apapam02/Audio-Modulated-555-based-flyback-driver/images/driver_top.jpg

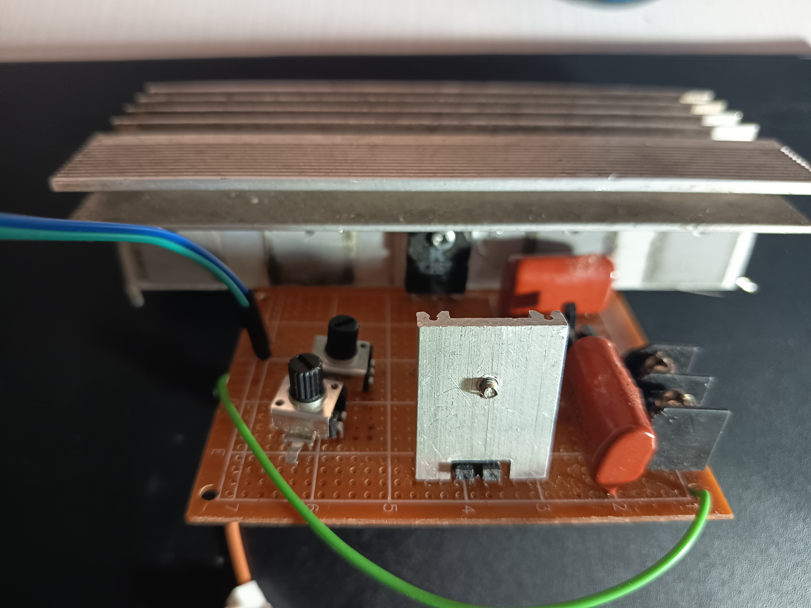
images/driver_top.jpg
