apapam02/Audio-Modulated-555-based-flyback-driver/images/Screenshot 2026-10-02 194719.png

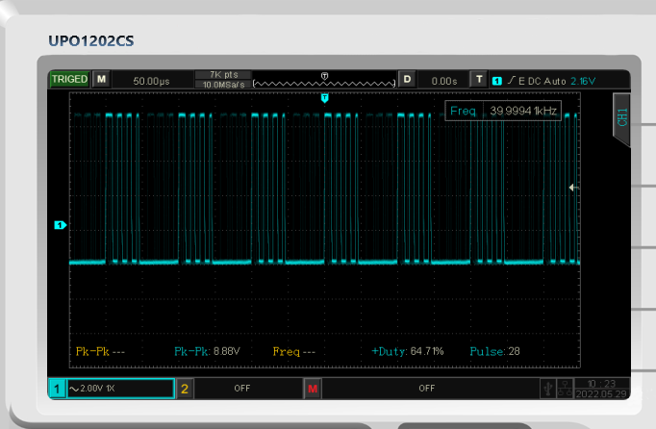
images/Screenshot 2026-10-02 194719.png
