apapam02/Audio-Modulated-555-based-flyback-driver/(commit log)

2026-10-02 Add measurements section to README
    Added measurements section with details on carrier signal, switching edges, and modulated output.
2026-10-02 Revise supply details and flyback transformer source
    Updated supply voltage range and clarified flyback transformer source in README.
2026-10-02 Add build section to README with assembly details
    Added build section with details on driver assembly and images.
